BearShang/motor_drv-software/docs/schematic.md

---
title: 原理图
---

# 原理图

## PWR

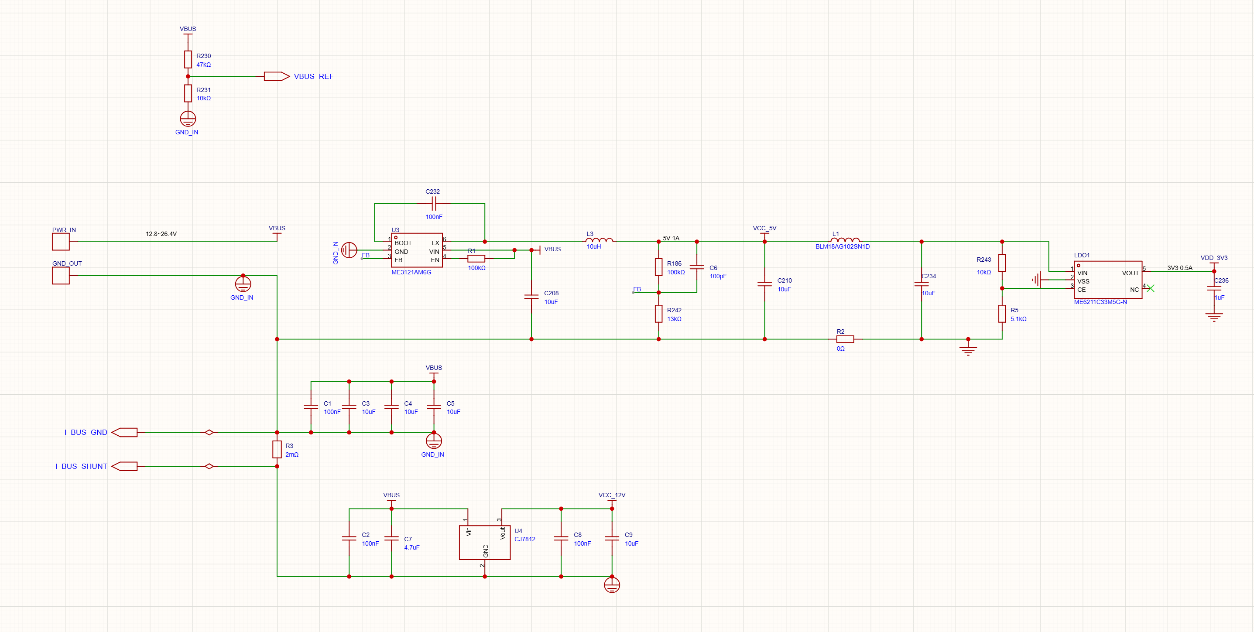
[picture p3: docs/pics/image.png]
PWR 原理图


## MCU

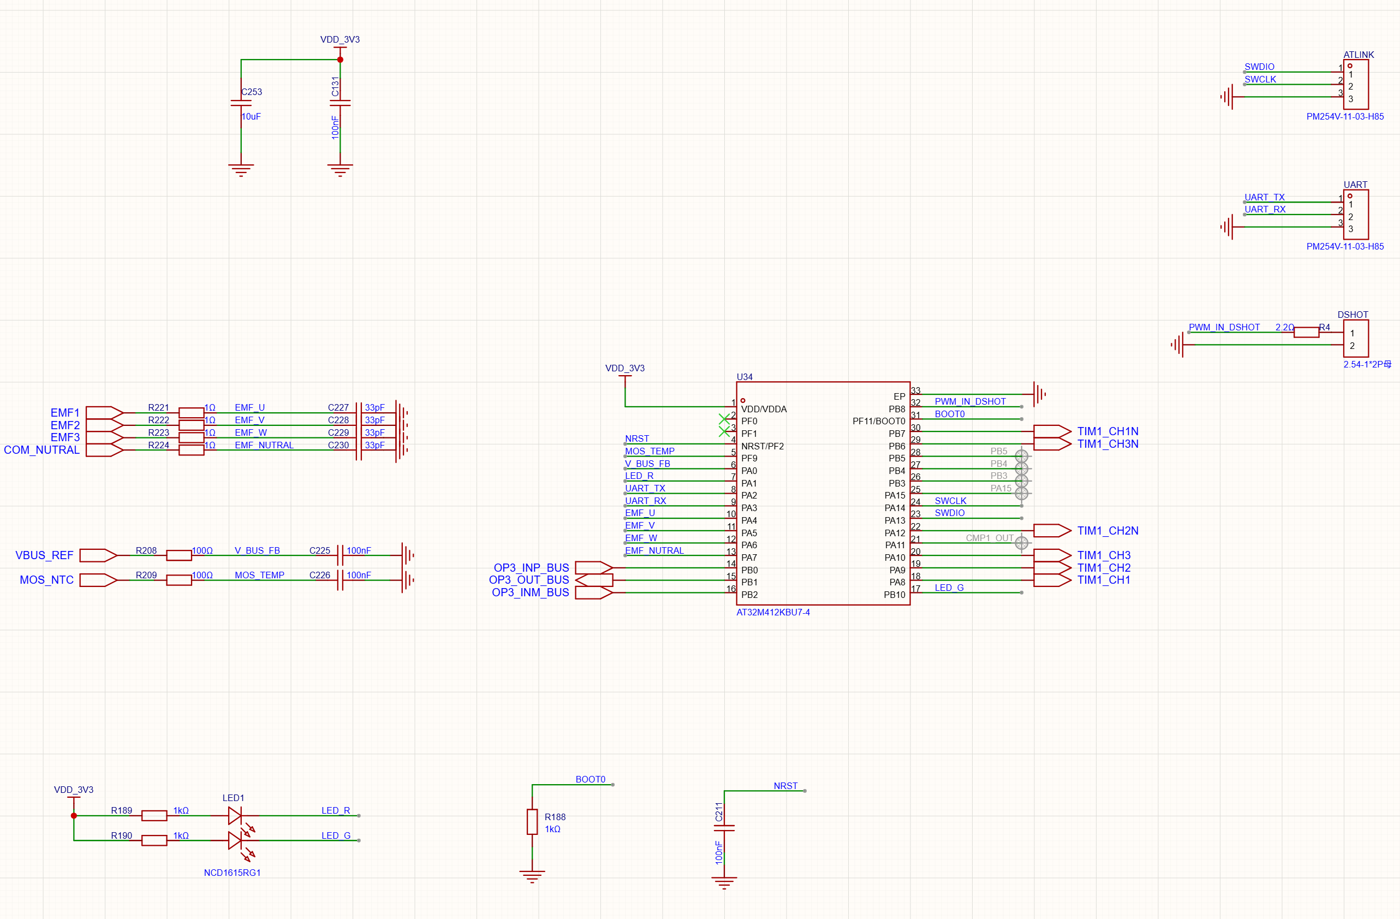
[picture p4: docs/pics/image-1.png]
MCU 原理图


## Driver

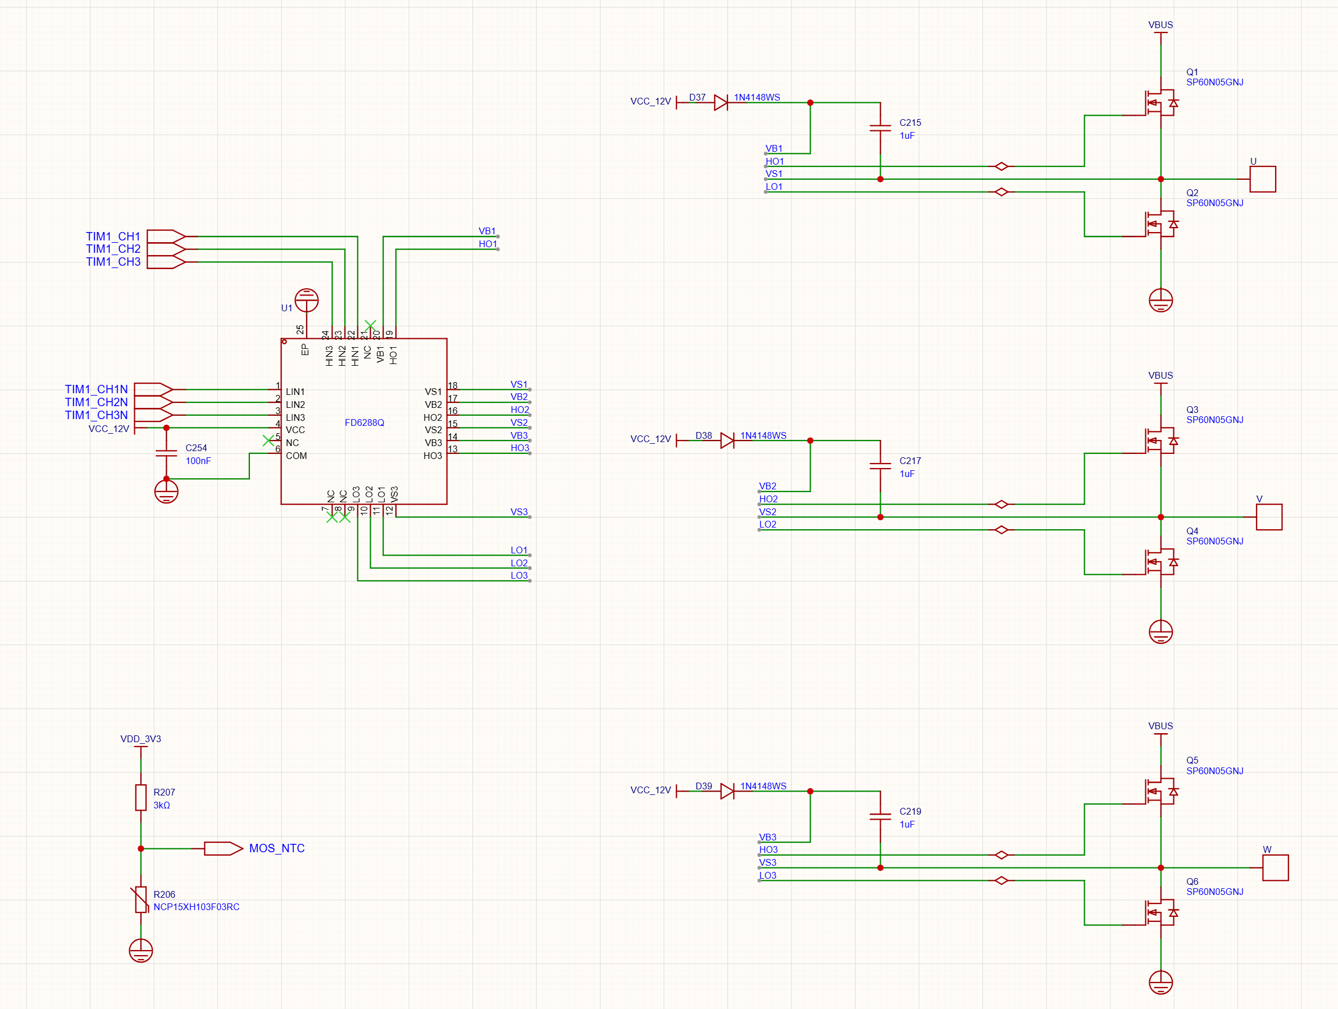
[picture p5: docs/pics/image-2.png]
Driver 原理图


## Sensing

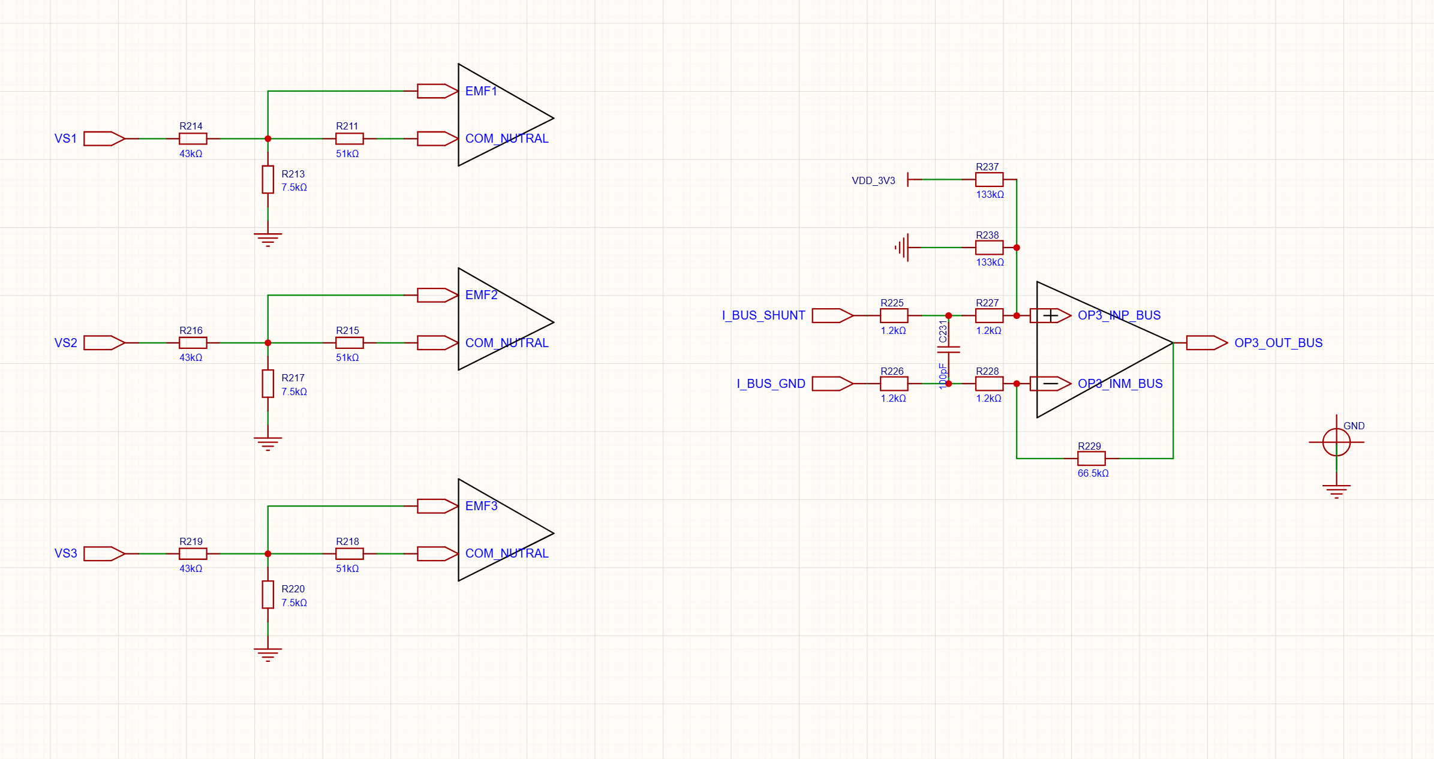
[picture p6: docs/pics/image-3.png]
Sensing 原理图
