BearShang/motor_drv-software/docs/intro.md

---
title: 简介
layout: redirect
redirect_to: /
---
