BearShang/motor_drv-software/docs/pics/motor-control/figure-01.jpg

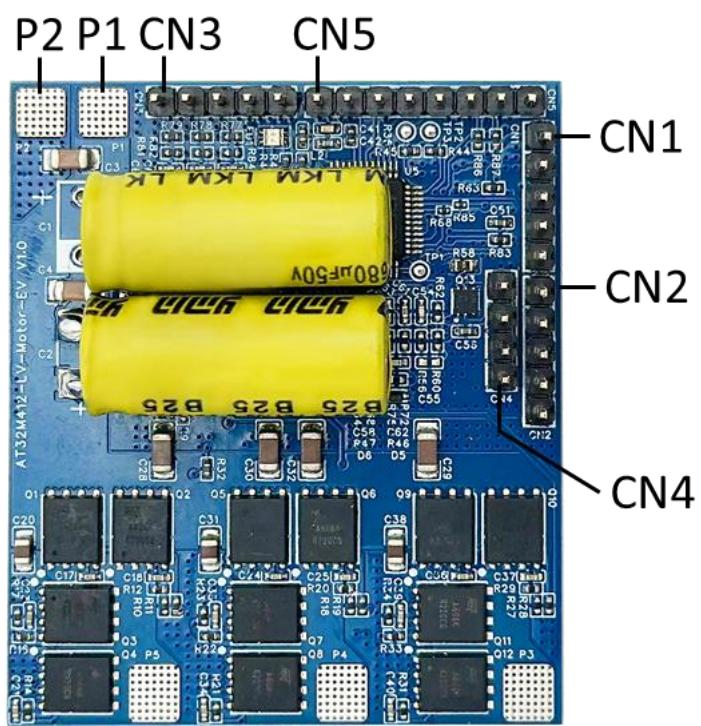
docs/pics/motor-control/figure-01.jpg
