BearShang/motor_drv-software/docs/pics/motor-control/figure-04.jpg

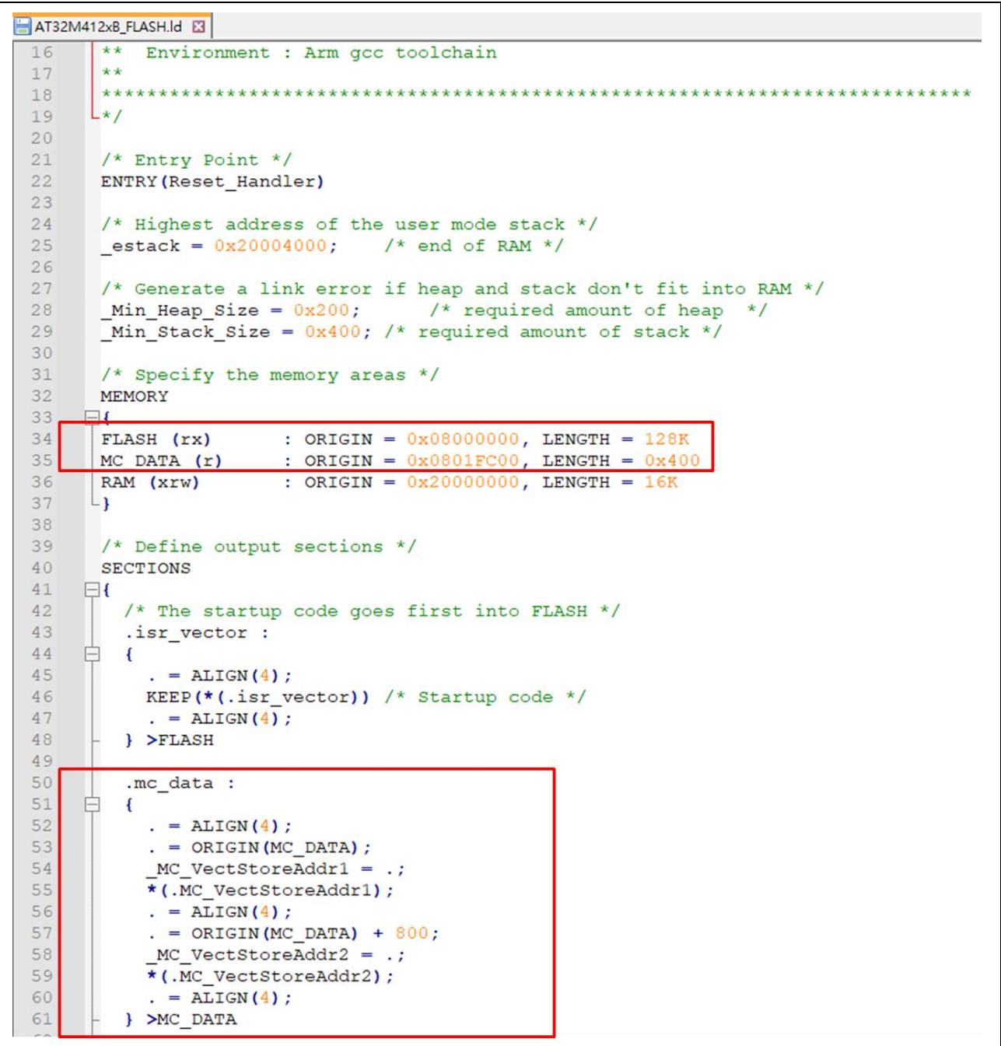
docs/pics/motor-control/figure-04.jpg
