BearShang/motor_drv-software/docs/pics/motor-control/figure-05.jpg

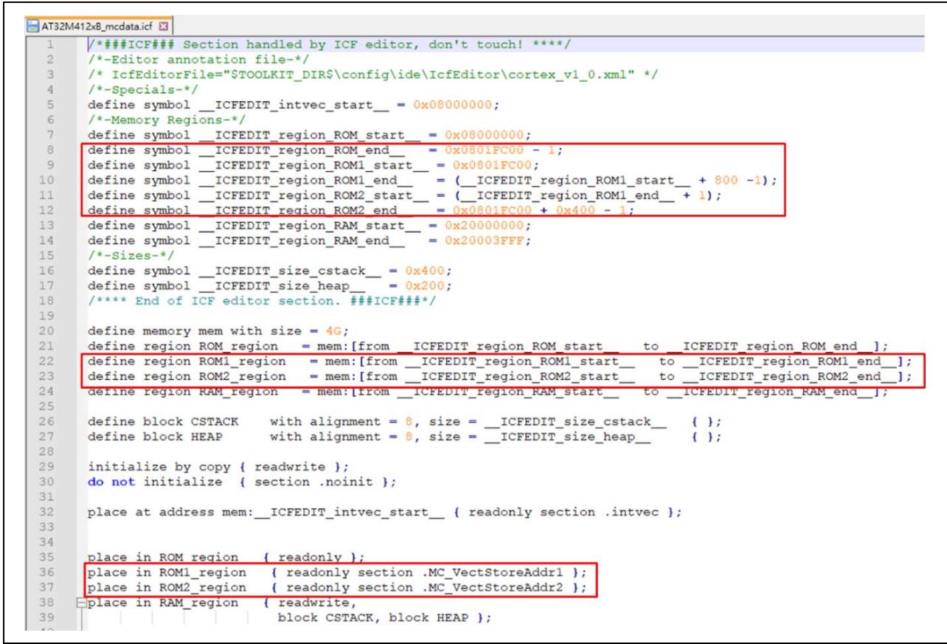
docs/pics/motor-control/figure-05.jpg
