BearShang/motor_drv-software/docs/pics/motor-control/figure-06.jpg

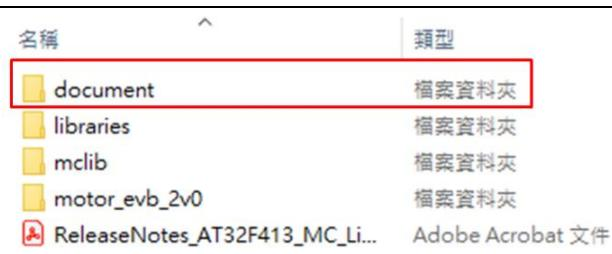
docs/pics/motor-control/figure-06.jpg
