BearShang/motor_drv-software/docs/pics/motor-control/figure-07.jpg

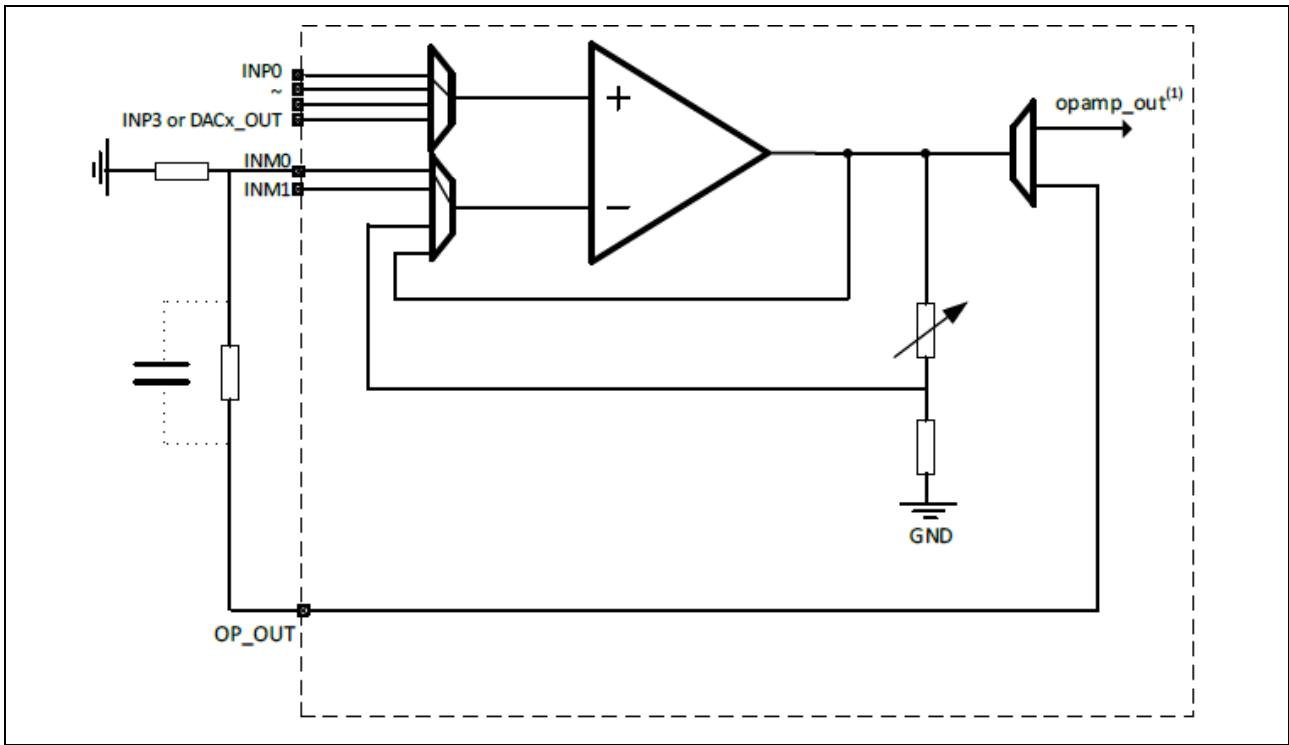
docs/pics/motor-control/figure-07.jpg
