BearShang/motor_drv-software/docs/pics/motor-control/figure-08.jpg

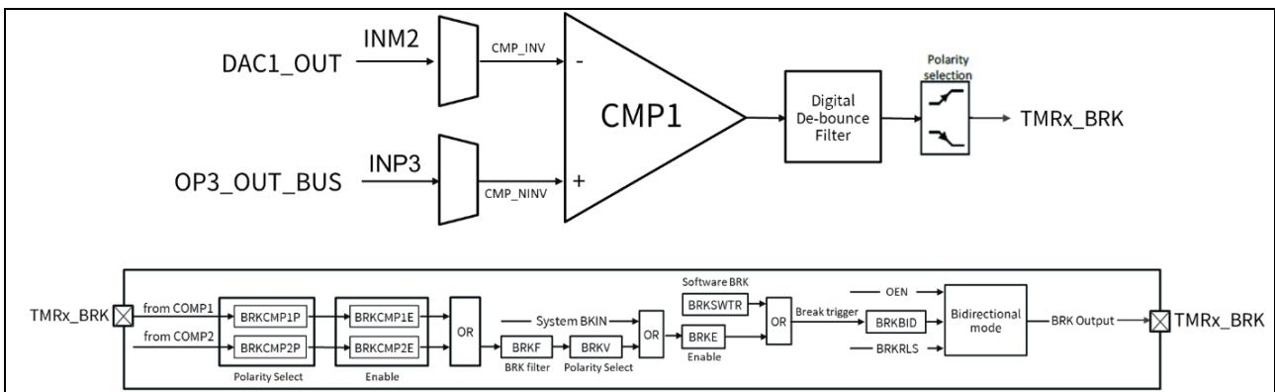
docs/pics/motor-control/figure-08.jpg
