BearShang/motor_drv-software/docs/pics/motor-control/figure-09.jpg

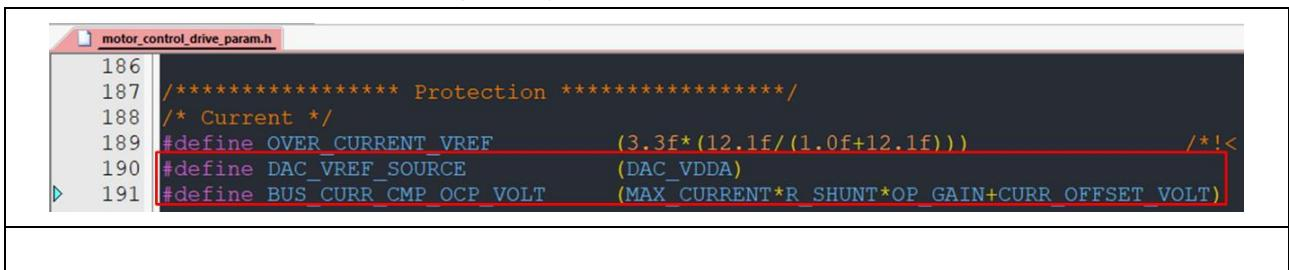
docs/pics/motor-control/figure-09.jpg
