BearShang/motor_drv-software/docs/pics/motor-control/figure-10.jpg

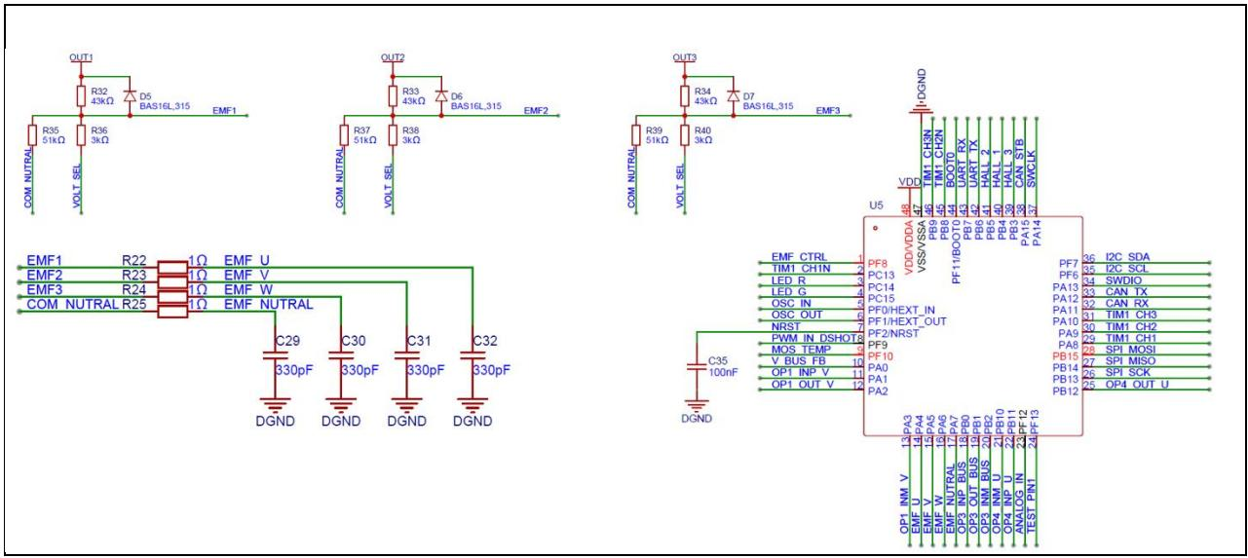
docs/pics/motor-control/figure-10.jpg
