BearShang/motor_drv-software/docs/pics/motor-control/figure-11.jpg

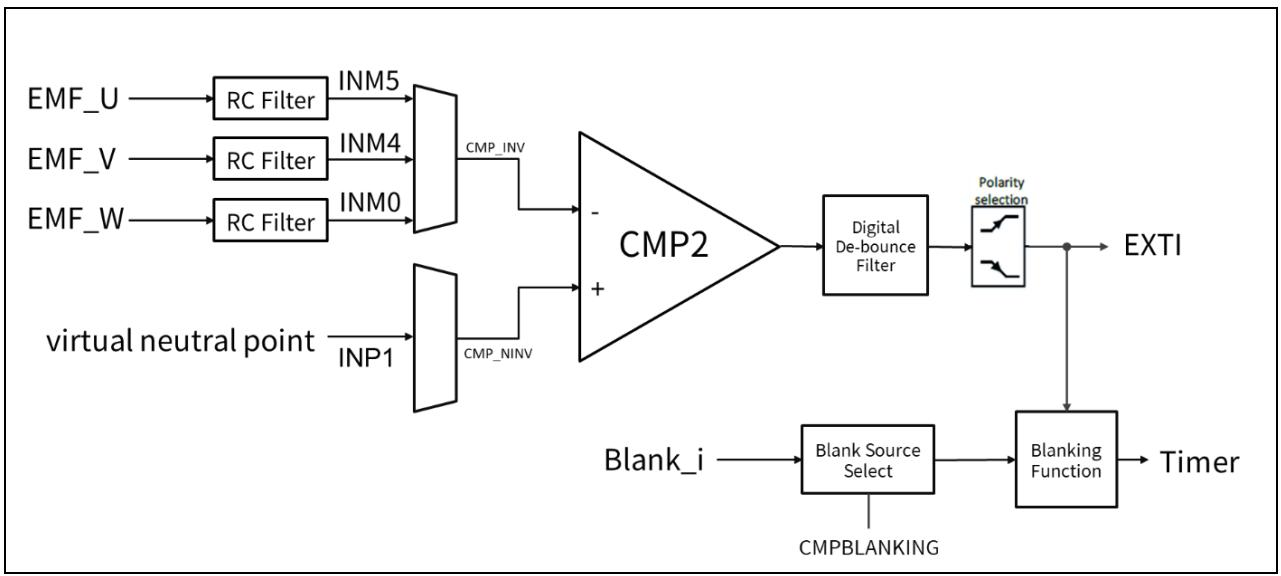
docs/pics/motor-control/figure-11.jpg
