BearShang/motor_drv-software/docs/pics/motor-control/figure-12.jpg

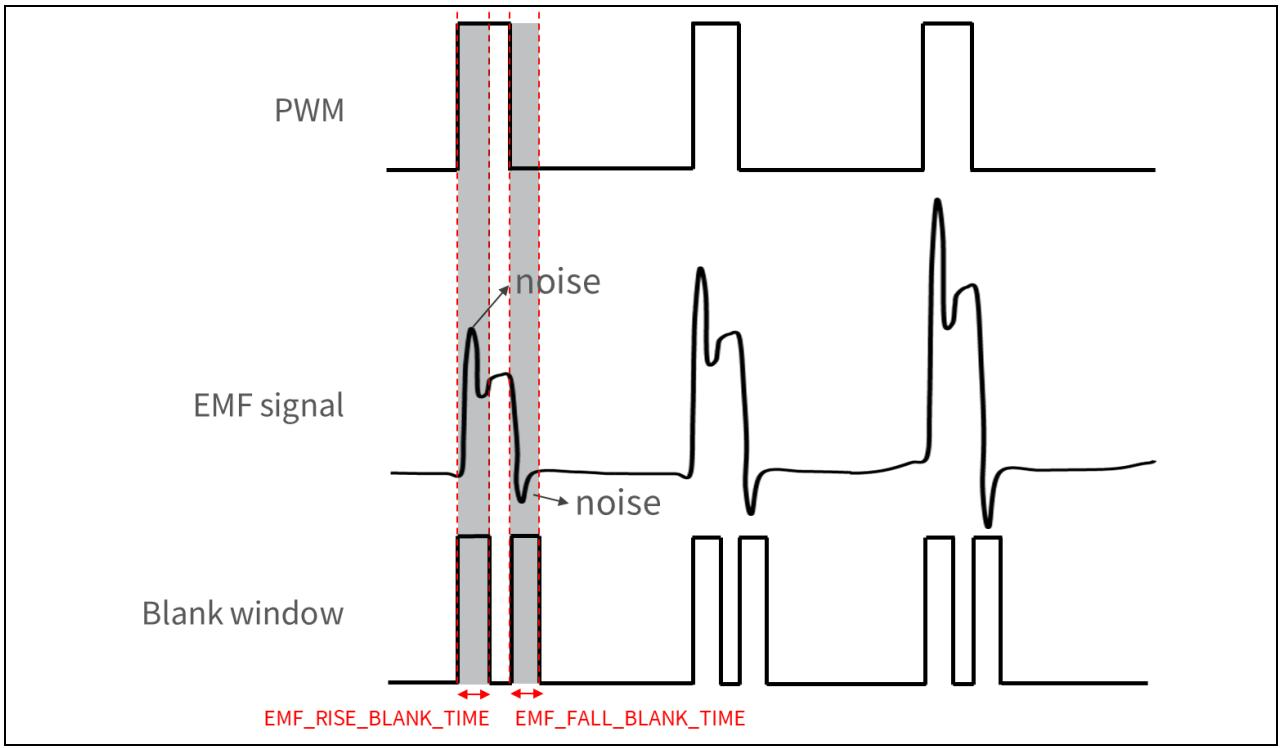
docs/pics/motor-control/figure-12.jpg
