BearShang/motor_drv-software/docs/pics/motor-control/figure-13.jpg

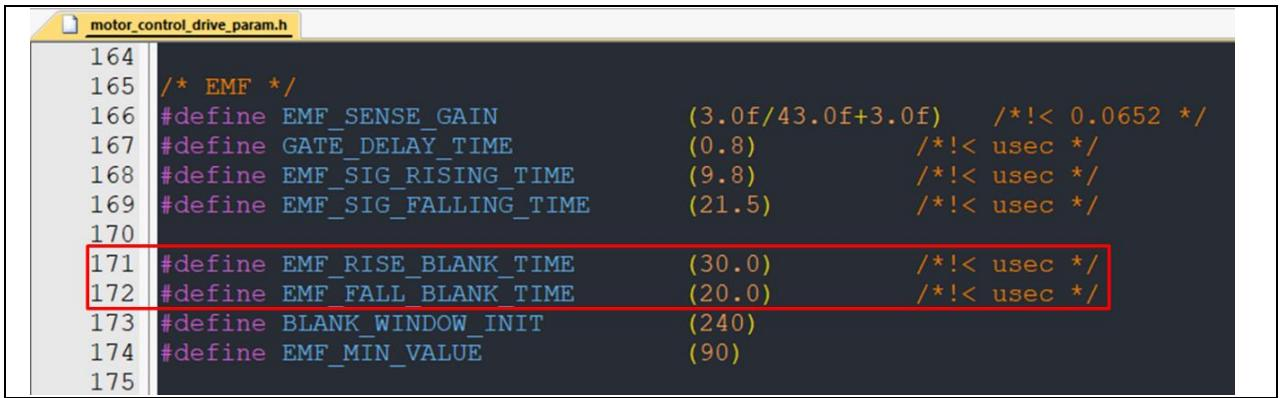
docs/pics/motor-control/figure-13.jpg
