BearShang/motor_drv-software/docs/pics/performance-tuning/basic.png

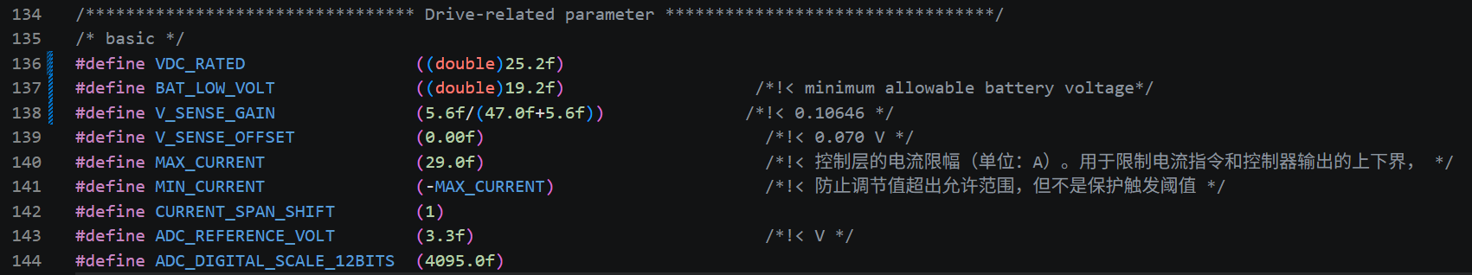
docs/pics/performance-tuning/basic.png
