BearShang/motor_drv-software/docs/pics/performance-tuning/performance-tuning34.jpg

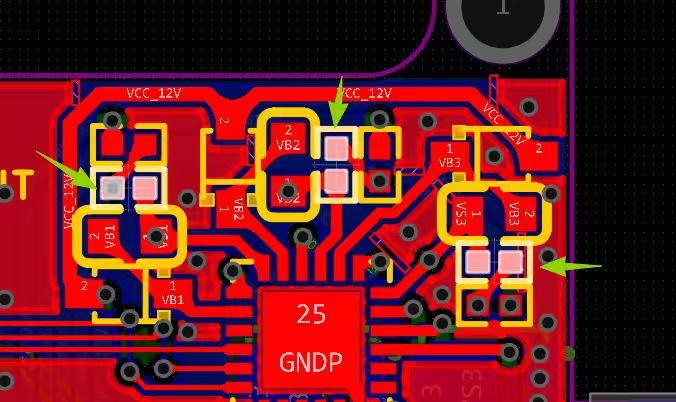
docs/pics/performance-tuning/performance-tuning34.jpg
