BearShang/motor_drv-software/firmware/mclib/src/mc_bldc.c

/**
  **************************************************************************
  * @file     mc_bldc.c
  * @brief    BLDC-related functions
  **************************************************************************
  *                       Copyright notice & Disclaimer
  *
  * The software Board Support Package (BSP) that is made available to
  * download from Artery official website is the copyrighted work of Artery.
  * Artery authorizes customers to use, copy, and distribute the BSP
  * software and its related documentation for the purpose of design and
  * development in conjunction with Artery microcontrollers. Use of the
  * software is governed by this copyright notice and the following disclaimer.
  *
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
  **************************************************************************
  */
#include "mc_lib.h"
extern volatile uint32_t system_time_ms;

/** @addtogroup Motor_Control_Library
  * @{
  */

/** @defgroup mc_bldc
  * @brief BLDC-related functions
  * @{
  */

/**
* @brief  configuration of pwm timer outputs
* @param  hall_states : hall state
* @retval none
*/
void bldc_output_config(uint8_t hall_states)
{
  uint16_t temp;

  temp = PWM_ADVANCE_TIMER->cm1;
  temp &= (~TMR_PWM_MODE_CM1_MASK);
  temp |= tmr_pwm_channel_mode[hall_states][0];
  PWM_ADVANCE_TIMER->cm1 = temp;

  temp = PWM_ADVANCE_TIMER->cm2;
  temp &= (~TMR_PWM_MODE_CM2_MASK);
  temp |= tmr_pwm_channel_mode[hall_states][1];
  PWM_ADVANCE_TIMER->cm2 = temp;

  temp = PWM_ADVANCE_TIMER->cctrl;
  temp &= (~TMR_PWM_OUT_MODE_MASK);
  temp |= tmr_pwm_output_mode[hall_states];
  PWM_ADVANCE_TIMER->cctrl = temp;
}

/**
  * @brief  start bldc setting
  * @param  none
  * @retval none
  */
void start_bldc(void)
{
#if defined HALL_SENSORS
  error_code |= error_code_mask & read_hall_state(&hall);

  /* clear interrupt flags of hall timer */
  tmr_flag_clear(HALL_CAPTURE_TIMER, TMR_OVF_FLAG | TMR_TRIGGER_FLAG | TMR_HALL_FLAG);

  /* set dir: CW or CCW */
  if(ctrl_source == CTRL_SOURCE_EXTERNAL)
  {
#if !defined AT32M412xx
    rotor_speed.dir = gpio_input_data_bit_read(MODE1_BUTTON_PORT, MODE1_BUTTON_PIN);
#endif
  }
  else if(ctrl_source == CTRL_SOURCE_SOFTWARE)
  {
    if(ctrl_mode == SPEED_CTRL)
    {
      if(speed_ramp.cmd_final > 0)
      {
        rotor_speed.dir = CW;
      }
      else
      {
        rotor_speed.dir = CCW;
      }
    }
    else if(ctrl_mode == TORQUE_CTRL)
    {
      if(current.Ibus.Iref > 0)
      {
        rotor_speed.dir = CW;
      }
      else
      {
        rotor_speed.dir = CCW;
      }
    }
  }

  /* set first hall state output */
  bldc_output_config(output_hall_state[rotor_speed.dir][hall.state]);

  if(rotor_speed.dir == CW)
  {
    motor_cw_init();
  }
  else
  {
    motor_ccw_init();
  }

  /* update pwm output mode from shadow buffer of timer cctrl reg. */
  tmr_event_sw_trigger(PWM_ADVANCE_TIMER, TMR_HALL_SWTRIG);

  /* set hall pre_state */
  hall.pre_state = hall.state;

  /* find next hall state */
  hall.next_state = next_hall_state[rotor_speed.dir][hall.state];

  /* set pwm output mode in shadow buffer of timer cctrl reg. */
  bldc_output_config(output_hall_state[rotor_speed.dir][hall.next_state]);

  /* reset counter value */
  PWM_ADVANCE_TIMER->cval = 0;

  /* enable overflow and trigger interrup of hall timer */
  tmr_interrupt_enable(HALL_CAPTURE_TIMER, TMR_C4_INT | TMR_TRIGGER_INT, TRUE);

  /* enable hall timer */
  tmr_counter_enable(HALL_CAPTURE_TIMER, TRUE);

  /* enable pwm timer output */
  tmr_output_enable(PWM_ADVANCE_TIMER, TRUE);

#elif defined SENSORLESS
  /* reset counter value */
  PWM_ADVANCE_TIMER->cval = 0;
  ADC_TIMER->cval = 0;
  blank_trigger.TMRx->cval = 0;
  blank.TMRx->cval = 0;

  /* set pwm output mode in shadow buffer of timer cctrl reg. */
  bldc_output_config(output_hall_state[rotor_speed.dir][hall.state]);

  /* update pwm output mode from shadow buffer of timer cctrl reg. */
  tmr_event_sw_trigger(PWM_ADVANCE_TIMER, TMR_HALL_SWTRIG);

  /* enable pwm timer output */
  tmr_output_enable(PWM_ADVANCE_TIMER, TRUE);

  /* enable blank trigger timer output */
  tmr_output_enable(blank_trigger.TMRx, TRUE);
  tmr_output_enable(blank.TMRx, TRUE);

  /* enable adc timer */
  ADC_TIMER->ctrl1_bit.tmren = TRUE;
  /* enable pwm timer */
  PWM_ADVANCE_TIMER->ctrl1_bit.tmren = TRUE;
  /* enable blank trigger timer */
  blank_trigger.TMRx->ctrl1_bit.tmren = TRUE;
  blank.TMRx->ctrl1_bit.tmren = TRUE;
  COMP_OUT_CAPTURE_TIMER->ctrl1_bit.tmren = TRUE;
#endif
}

/**
  * @brief  Rotor alignment (BLDC)
  * @param  none
  * @retval none
  */
void align_bldc(void)
{
  /* set pwm output mode in shadow buffer of timer cctrl reg. */
  bldc_output_config(hall.state);
  /* update pwm output mode from shadow buffer of timer cctrl reg. */
  tmr_event_sw_trigger(PWM_ADVANCE_TIMER, TMR_HALL_SWTRIG);
  /* set align volt */
  volt_cmd = (int16_t)((uint32_t)(calcValueByVref(LOCK_VOLT_CMD) * vdc_ratio) >> VBUS_GAIN_LOG);
  pwm_comp_value = (volt_cmd * (PWM_PERIOD + 1)) >> 15;

  PWM_ADVANCE_TIMER->c1dt = pwm_comp_value;
  PWM_ADVANCE_TIMER->c2dt = pwm_comp_value;
  PWM_ADVANCE_TIMER->c3dt = pwm_comp_value;

  /* enable pwm timer */
  tmr_counter_enable(PWM_ADVANCE_TIMER, TRUE);

  /* enable pwm timer output */
  tmr_output_enable(PWM_ADVANCE_TIMER, TRUE);
}

/**
  * @brief  Open-loop control function (BLDC)
  * @param  hall_handler : Hall sensor related structure variables
  * @param  openloop_handler : Open-loop related structure variables
  * @param  rotor_speed : Speed-related structure variables
  * @retval none
  */
void bldc_open_loop_ctrl(hall_sensor_type *hall_handler, olc_type *openloop_handler, speed_type *rotor_speed)
{
  volt_cmd = openloop_handler->volt_ref * current.volt_sign;

  if(openloop_handler->olc_count > openloop_handler->period_ref)
  {
    /* Set next state */
    hall_handler->next_state = next_hall_state[rotor_speed->dir][hall_handler->state];

    /* Change mode **/
    bldc_output_config(output_hall_state[rotor_speed->dir][hall_handler->next_state]);

    /* Change phase trigger **/
    tmr_event_sw_trigger(PWM_ADVANCE_TIMER, TMR_HALL_SWTRIG);

    /* Renew hall state */
    hall_handler->state = hall_handler->next_state;

    /* Speed estimation */
    rotor_speed->interval_filter.long_word = openloop_handler->period_ref * PWM_PERIOD * (1 - 2 * rotor_speed->dir);

    /* set flag to calculate motor speed in main function */
    calc_spd_rdy = SET;

    openloop_handler->olc_count = 0;
    rotor_speed->speed_count = 0;
  }
  else
  {
    openloop_handler->olc_count++;
  }
}

/**
  * @brief  bldc hall auto learning function (BLDC)
  * @param  hall_handler : Hall sensor related structure variables
  * @param  hall_learn : Hall Sensor Auto-Learning related structure variables
  * @retval none
  */
void bldc_hall_learning(hall_sensor_type *hall_handler, hall_learn_type *hall_learn)
{
  if(hall_learn->count > hall_learn->learn_period)
  {
    /* Set next state */
    hall_handler->next_state = next_hall_state[hall_learn->dir][hall_handler->next_state];

    /* Change mode **/
    bldc_output_config(output_hall_state[hall_learn->dir][hall_handler->next_state]);

    /* update pwm output mode from shadow buffer of timer cctrl reg. */
    tmr_event_sw_trigger(PWM_ADVANCE_TIMER, TMR_HALL_SWTRIG);

    hall_learn->count = 0;
  }
  else
  {
    hall_learn->count++;
  }
}

/**
  * @brief  Configures PWM braking for motor control
  * @param  brake_force_duty : Braking force duty cycle (0-100%)
  * @note   0% = no braking, 100% = full braking force
  * @retval none
  */
void brake_config(uint16_t brake_force_duty)
{
  uint16_t temp, brake_pwm_cval;
  gpio_init_type gpio_init_struct = {0};

  /* pwm timer output disable */
  tmr_output_enable(PWM_ADVANCE_TIMER, FALSE);
  /* disable pwm timer */
  tmr_counter_enable(PWM_ADVANCE_TIMER, FALSE);

  /* timer pwm output pin Configuration */
  gpio_default_para_init(&gpio_init_struct);
  gpio_init_struct.gpio_mode = GPIO_MODE_OUTPUT;

  /* High-side, Phase A,B,C Config */
  gpio_init_struct.gpio_pins = PWM_PHASE_A_HI_GPIO_PIN;
  gpio_init(PWM_PHASE_A_HI_PORT, &gpio_init_struct);
#if !defined AT32F403Axx && !defined AT32F407xx && !defined AT32F413xx && !defined AT32F415xx
  gpio_pin_mux_config(PWM_PHASE_A_HI_PORT, PWM_PHASE_A_HI_PIN_SOURCE, PWM_PHASE_A_HI_IOMUX);
#endif

  gpio_init_struct.gpio_pins = PWM_PHASE_B_HI_GPIO_PIN;
  gpio_init(PWM_PHASE_B_HI_PORT, &gpio_init_struct);
#if !defined AT32F403Axx && !defined AT32F407xx && !defined AT32F413xx && !defined AT32F415xx
  gpio_pin_mux_config(PWM_PHASE_B_HI_PORT, PWM_PHASE_B_HI_PIN_SOURCE, PWM_PHASE_B_HI_IOMUX);
#endif

  gpio_init_struct.gpio_pins = PWM_PHASE_C_HI_GPIO_PIN;
  gpio_init(PWM_PHASE_C_HI_PORT, &gpio_init_struct);
#if !defined AT32F403Axx && !defined AT32F407xx && !defined AT32F413xx && !defined AT32F415xx
  gpio_pin_mux_config(PWM_PHASE_C_HI_PORT, PWM_PHASE_C_HI_PIN_SOURCE, PWM_PHASE_C_HI_IOMUX);
#endif

  /* close AH/BH/CH */
  gpio_bits_write(PWM_PHASE_A_HI_PORT, PWM_PHASE_A_HI_GPIO_PIN, FALSE);
  gpio_bits_write(PWM_PHASE_B_HI_PORT, PWM_PHASE_B_HI_GPIO_PIN, FALSE);
  gpio_bits_write(PWM_PHASE_C_HI_PORT, PWM_PHASE_C_HI_GPIO_PIN, FALSE);

  temp = PWM_ADVANCE_TIMER->cm1;
  temp &= (~TMR_PWM_MODE_CM1_MASK);
  temp |= BRAKE_PWM_MODE_CM1;
  PWM_ADVANCE_TIMER->cm1 = temp;

  temp = PWM_ADVANCE_TIMER->cm2;
  temp &= (~TMR_PWM_MODE_CM2_MASK);
  temp |= BRAKE_PWM_MODE_CM2;
  PWM_ADVANCE_TIMER->cm2 = temp;

  temp = PWM_ADVANCE_TIMER->cctrl;
  temp &= (~TMR_PWM_OUT_MODE_MASK);
  temp |= BRAKE_PWM_OUT_CCTRL;
  PWM_ADVANCE_TIMER->cctrl = temp;

  /* calculate brake force */
#if defined GATE_DRIVER_LOW_SIDE_INVERT
  brake_pwm_cval = (100 - brake_force_duty) * PWM_PERIOD_DIV_100;
#else
  brake_pwm_cval = brake_force_duty * PWM_PERIOD_DIV_100;
#endif

  /* set brake duty */
  tmr_channel_value_set(PWM_ADVANCE_TIMER, TMR_SELECT_CHANNEL_1, brake_pwm_cval);
  tmr_channel_value_set(PWM_ADVANCE_TIMER, TMR_SELECT_CHANNEL_2, brake_pwm_cval);
  tmr_channel_value_set(PWM_ADVANCE_TIMER, TMR_SELECT_CHANNEL_3, brake_pwm_cval);
  tmr_channel_value_set(PWM_ADVANCE_TIMER, TMR_SELECT_CHANNEL_4, brake_pwm_cval);

  /* update pwm output mode from shadow buffer of timer cctrl reg. */
  tmr_event_sw_trigger(PWM_ADVANCE_TIMER, TMR_HALL_SWTRIG);

  /* reset counter value */
  PWM_ADVANCE_TIMER->cval = 0;

  /* pwm timer output enable */
  tmr_output_enable(PWM_ADVANCE_TIMER, TRUE);

  /* enable pwm timer */
  tmr_counter_enable(PWM_ADVANCE_TIMER, TRUE);
}

/**
  * @brief  Motor beep function - generates audible tone by switching motor coils
  * @param  frequency : Tone frequency in Hz (20~20000 Hz)
  * @param  duration  : Duration in milliseconds
  * @param  volume    : Volume level (0-100), controls PWM duty cycle
  * @retval none
  * @note   Uses two-phase switching to avoid MOS overheating
  */
void motor_beep(uint16_t frequency, uint32_t duration, uint8_t volume)
{
  uint32_t toggle_period_us;
  uint32_t elapsed_us = 0;
  uint32_t total_duration_us = duration * 1000;
  uint16_t pwm_duty;
  uint8_t phase_step = 0;
  
  uint32_t saved_cm1 = PWM_ADVANCE_TIMER->cm1;
  uint32_t saved_cm2 = PWM_ADVANCE_TIMER->cm2;
  uint32_t saved_cctrl = PWM_ADVANCE_TIMER->cctrl;
  uint32_t saved_brk = PWM_ADVANCE_TIMER->brk;
  err_code_type saved_error_code = error_code;

  /* 改动1：OCP 阈值从 10A 放宽到 20A，作为极端情况的最后保险 */
  #define BEEP_FIXED_OCP_DAC_VAL  ((uint16_t)(63.0 * (10.0 * R_SHUNT * OP_GAIN + CURR_OFFSET_VOLT) / ADC_REFERENCE_VOLT))
  dac_1_data_set(BEEP_FIXED_OCP_DAC_VAL);

  /* 改动2：关闭硬件 BRK，这是声音能从"很小"变"响亮"的核心。
     蜂鸣时间很短（几百毫秒）且电机静止，风险可控。 */
  PWM_ADVANCE_TIMER->brk_bit.brken = FALSE;

  tmr_interrupt_enable(PWM_ADVANCE_TIMER, TMR_BRK_INT, FALSE);

  if(frequency < 20) frequency = 20;
  if(frequency > 20000) frequency = 20000;
  if(volume > 100) volume = 100; 

  toggle_period_us = 500000 / frequency;
  if(toggle_period_us < 25) toggle_period_us = 25;

  pwm_duty = (uint16_t)((uint32_t)volume * PWM_PERIOD / 1000); 
  if(pwm_duty < 5) pwm_duty = 5;

  /* 改动3：加占空比硬上限 20%，防止低阻电机在关 BRK 后电流失控。
     如果 20% 声音够了但 MOS 发热，可放宽到 /6(~16%) 或 /8(~12%)。
     如果 20% 还不够且 MOS 不烫，可放宽到 /4(25%)。 */
  #define MAX_BEEP_DUTY  (PWM_PERIOD / 5)
  if(pwm_duty > MAX_BEEP_DUTY)
    pwm_duty = MAX_BEEP_DUTY;

  tmr_output_enable(PWM_ADVANCE_TIMER, FALSE);

  while(elapsed_us < total_duration_us)
  {
    switch(phase_step)
    {
      case 0:
        PWM_ADVANCE_TIMER->cm1 = AH_BL_PWM_MODE_CM1;
        PWM_ADVANCE_TIMER->cm2 = AH_BL_PWM_MODE_CM2;
        PWM_ADVANCE_TIMER->cctrl = AH_BL_PWM_OUT_CCTRL;
        break;
      case 1:
        PWM_ADVANCE_TIMER->cm1 = BH_AL_PWM_MODE_CM1;
        PWM_ADVANCE_TIMER->cm2 = BH_AL_PWM_MODE_CM2;
        PWM_ADVANCE_TIMER->cctrl = BH_AL_PWM_OUT_CCTRL;
        break;
      case 2:
        PWM_ADVANCE_TIMER->cm1 = AH_CL_PWM_MODE_CM1;
        PWM_ADVANCE_TIMER->cm2 = AH_CL_PWM_MODE_CM2;
        PWM_ADVANCE_TIMER->cctrl = AH_CL_PWM_OUT_CCTRL;
        break;
      case 3:
        PWM_ADVANCE_TIMER->cm1 = CH_AL_PWM_MODE_CM1;
        PWM_ADVANCE_TIMER->cm2 = CH_AL_PWM_MODE_CM2;
        PWM_ADVANCE_TIMER->cctrl = CH_AL_PWM_OUT_CCTRL;
        break;
      default:
        phase_step = 0;
        break;
    }

    PWM_ADVANCE_TIMER->c1dt = pwm_duty;
    PWM_ADVANCE_TIMER->c2dt = pwm_duty;
    PWM_ADVANCE_TIMER->c3dt = pwm_duty;

    tmr_event_sw_trigger(PWM_ADVANCE_TIMER, TMR_HALL_SWTRIG);
    tmr_output_enable(PWM_ADVANCE_TIMER, TRUE);

    uint32_t delay_cnt = toggle_period_us;
    while(delay_cnt >= 1000)
    {
      mc_delay_ms(1);
      delay_cnt -= 1000;
    }
    if(delay_cnt > 0)
    {
      mc_delay_us(delay_cnt);
    }
    
    elapsed_us += toggle_period_us;
    phase_step++;
    if(phase_step > 3) phase_step = 0;
  }

  tmr_output_enable(PWM_ADVANCE_TIMER, FALSE);
  PWM_ADVANCE_TIMER->c1dt = 0;
  PWM_ADVANCE_TIMER->c2dt = 0;
  PWM_ADVANCE_TIMER->c3dt = 0;
  
  PWM_ADVANCE_TIMER->cm1 = saved_cm1;
  PWM_ADVANCE_TIMER->cm2 = saved_cm2;
  PWM_ADVANCE_TIMER->cctrl = saved_cctrl;
  tmr_event_sw_trigger(PWM_ADVANCE_TIMER, TMR_HALL_SWTRIG);

  tmr_flag_clear(PWM_ADVANCE_TIMER, TMR_BRK_FLAG);
  if (!(saved_error_code & MC_OVER_CURRENT_ERROR))
  {
    error_code &= ~MC_OVER_CURRENT_ERROR;
  }

  /* 恢复 BRK 和中断，不影响正常运行 */
  PWM_ADVANCE_TIMER->brk = saved_brk;
  tmr_interrupt_enable(PWM_ADVANCE_TIMER, TMR_BRK_INT, TRUE);
  
  dac_1_data_set(DAC_OCP_REF);
}
/**
  * @brief  Play "Castle in the Sky" (Laputa) melody
  * @param  volume : Volume level (0-100)
  * @retval none
  */
void motor_play_laputa(uint8_t volume)
{
  /* Musical Note Frequencies (Hz) */
  #define NOTE_G4  392
  #define NOTE_A4  440
  #define NOTE_B4  494
  #define NOTE_C5  523
  #define NOTE_D5  587
  #define NOTE_E5  659
  #define NOTE_F5  698
  #define NOTE_G5  784

  /* Tempo: Quarter note = 400ms */
  uint32_t q = 400; 
  uint32_t h = q / 2; // Half note (eighth)
  
  /* Melody: 6 7 | 1' 7 1' 3' | 7 - - 3 | 6 5 6 1' | 5 - - */
  
  // 6 7
  motor_beep(NOTE_A4, h, volume); mc_delay_ms(50);
  motor_beep(NOTE_B4, h, volume); mc_delay_ms(50);

  // 1' 7 1' 3'
  motor_beep(NOTE_C5, q + h, volume); mc_delay_ms(50);
  motor_beep(NOTE_B4, h, volume);     mc_delay_ms(50);
  motor_beep(NOTE_C5, q, volume);     mc_delay_ms(50);
  motor_beep(NOTE_E5, q, volume);     mc_delay_ms(50);

  // 7 - - 3
  motor_beep(NOTE_B4, q * 2, volume); mc_delay_ms(50);
  motor_beep(NOTE_E5, h, volume);     mc_delay_ms(50); // Using E5 as high 3

  // 6 5 6 1'
  motor_beep(NOTE_A4, q + h, volume); mc_delay_ms(50);
  motor_beep(NOTE_G4, h, volume);     mc_delay_ms(50);
  motor_beep(NOTE_A4, q, volume);     mc_delay_ms(50);
  motor_beep(NOTE_C5, q, volume);     mc_delay_ms(50);

  // 5 - -
  motor_beep(NOTE_G4, q * 2, volume); mc_delay_ms(50);
}

/**
  * @brief  Play custom startup melody: f4 e4 g3 _ a3 c4 d4
  * @param  volume : Volume level (0-100)
  * @retval none
  */
void motor_play_startup_tone(uint8_t volume)
{
  /* Frequencies for the requested sequence (Hz) */
  #define NOTE_F4  349
  #define NOTE_E4  330
  #define NOTE_G3  196
  #define NOTE_A3  220
  #define NOTE_C4  262
  #define NOTE_D4  294

  uint32_t note_duration = 180; // Standard duration for each note
  uint32_t gap = 40;            // Small gap between notes
  uint32_t long_pause = 150;    // The "_" in the sequence

  // f4 e4 g3
  motor_beep(NOTE_F4, note_duration, volume); mc_delay_ms(gap);
  motor_beep(NOTE_E4, note_duration, volume); mc_delay_ms(gap);
  motor_beep(NOTE_G3, note_duration, volume); 
  
  // _ (Pause)
  mc_delay_ms(long_pause);

  // a3 c4 d4
  motor_beep(NOTE_A3, note_duration, volume); mc_delay_ms(gap);
  motor_beep(NOTE_C4, note_duration, volume); mc_delay_ms(gap);
  motor_beep(NOTE_D4, note_duration, volume); mc_delay_ms(gap);
}
 
