BearShang/motor_drv-software/firmware/at32m412_lv_motor_ev/at32m412/bldc_1shunt_sensorless/src/at32m412_416_clock.c

/**
  **************************************************************************
  * @file     at32m412_416_clock.c
  * @brief    system clock config program
  **************************************************************************
  *                       Copyright notice & Disclaimer
  *
  * The software Board Support Package (BSP) that is made available to
  * download from Artery official website is the copyrighted work of Artery.
  * Artery authorizes customers to use, copy, and distribute the BSP
  * software and its related documentation for the purpose of design and
  * development in conjunction with Artery microcontrollers. Use of the
  * software is governed by this copyright notice and the following disclaimer.
  *
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
  **************************************************************************
  */

/* includes ------------------------------------------------------------------*/
#include "mc_lib.h"
#include "at32m412_416_clock.h"

/** @addtogroup at32m412_lv_motor_ev
  * @{
  */
  
/** @addtogroup bldc_1shunt_sensorless bldc_1shunt_sensorless
  * @{
  */

/** @defgroup at32m412_416_clock
  * @brief system clock config program
  * @{
  */

/**
  * @brief  system clock config program
  * @note   the system clock is configured as follow:
  *         system clock (sclk)   = (hext * pll_ns)/(pll_ms * pll_fr)
  *         system clock source   = pll (hext)
  *         - hext                = 24000000
  *         - sclk                = 180000000
  *         - ahbdiv              = 1
  *         - ahbclk              = 180000000
  *         - apb2div             = 1
  *         - apb2clk             = 180000000
  *         - apb1div             = 1
  *         - apb1clk             = 180000000
  *         - pll_ns              = 60
  *         - pll_ms              = 2
  *         - pll_fr              = 4
  *         - flash_wtcyc         = 5 cycle
  * @param  none
  * @retval none
  */
void system_clock_config(void)
{
  /* reset crm */
  crm_reset();

  /* config flash psr register */
  flash_psr_set(FLASH_WAIT_CYCLE_5);

  /* enable pwc periph clock */
  crm_periph_clock_enable(CRM_PWC_PERIPH_CLOCK, TRUE);

  /* set power ldo output voltage to 1.3v */
  pwc_ldo_output_voltage_set(PWC_LDO_OUTPUT_1V3);

#ifdef INTERNAL_CLOCK_SOURCE
  /* enable hick */
  crm_clock_source_enable(CRM_CLOCK_SOURCE_HICK, TRUE);

  /* wait till hick is ready */
  while(crm_flag_get(CRM_HICK_STABLE_FLAG) != SET)
  {
  }

  /*  if pll clock source selects hext with other frequency values, or configure pll to other
    frequency values, please use the at32 new clock  configuration tool for configuration. */
  crm_pll_config(CRM_PLL_SOURCE_HICK, 90, 1, CRM_PLL_FR_4);

#else
  /* enable hext */
  crm_clock_source_enable(CRM_CLOCK_SOURCE_HEXT, TRUE);

  /* wait till hext is ready */
  while(crm_hext_stable_wait() == ERROR)
  {
  }

  /* if pll parameter has changed, please use the AT32_New_Clock_Configuration tool for new configuration. */
  crm_pll_config(CRM_PLL_SOURCE_HEXT, 60, 2, CRM_PLL_FR_4);
#endif

  /* enable pll */
  crm_clock_source_enable(CRM_CLOCK_SOURCE_PLL, TRUE);

  /* wait till pll is ready */
  while(crm_flag_get(CRM_PLL_STABLE_FLAG) != SET)
  {
  }

  /* config ahbclk */
  crm_ahb_div_set(CRM_AHB_DIV_1);

  /* config apb3clk, the maximum frequency of APB3 clock is 90 MHz */
  crm_apb3_div_set(CRM_APB3_DIV_4);

  /* config apb2clk, the maximum frequency of APB2 clock is 180 MHz */
  crm_apb2_div_set(CRM_APB2_DIV_1);

  /* config apb1clk, the maximum frequency of APB1 clock is 180 MHz */
  crm_apb1_div_set(CRM_APB1_DIV_1);

  /* enable auto step mode */
  crm_auto_step_mode_enable(TRUE);

  /* select pll as system clock source */
  crm_sysclk_switch(CRM_SCLK_PLL);

  /* wait till pll is used as system clock source */
  while(crm_sysclk_switch_status_get() != CRM_SCLK_PLL)
  {
  }

  /* disable auto step mode */
  crm_auto_step_mode_enable(FALSE);

  /* update system_core_clock global variable */
  system_core_clock_update();
}
