BearShang/motor_drv-software/firmware/at32m412_lv_motor_ev/at32m412/bldc_1shunt_sensorless/src/at32m412_416_int.c

/**
  **************************************************************************
  * @file     at32m412_416_int.c
  * @brief    main interrupt service routines.
  **************************************************************************
  *                       Copyright notice & Disclaimer
  *
  * The software Board Support Package (BSP) that is made available to
  * download from Artery official website is the copyrighted work of Artery.
  * Artery authorizes customers to use, copy, and distribute the BSP
  * software and its related documentation for the purpose of design and
  * development in conjunction with Artery microcontrollers. Use of the
  * software is governed by this copyright notice and the following disclaimer.
  *
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
  **************************************************************************
  */

/* includes ------------------------------------------------------------------*/
#include "at32m412_416_int.h"

/** @addtogroup at32m412_lv_motor_ev
  * @{
  */
  
/** @addtogroup bldc_1shunt_sensorless bldc_1shunt_sensorless
  * @{
  */

/** @defgroup at32m412_416_int
  * @brief main interrupt service routines.
  * @{
  */

extern __IO uint16_t adc1_preempt_valuetab[2][3];
extern __IO uint16_t adc2_preempt_valuetab[2][3];
extern __IO uint16_t adc1_preempt_conversion_count;
extern __IO uint16_t adc2_preempt_conversion_count;
extern __IO uint32_t adc1_overflow_flag;
extern __IO uint32_t adc2_overflow_flag;
extern __IO uint32_t adc1_conversion_fail_flag;
extern __IO uint32_t adc2_conversion_fail_flag;

extern void adc_convert_recovery_process(void);

/**
  * @brief  this function handles nmi exception.
  * @param  none
  * @retval none
  */
void NMI_Handler(void)
{
}

/**
  * @brief  this function handles hard fault exception.
  * @param  none
  * @retval none
  */
void HardFault_Handler(void)
{
  /* go to infinite loop when hard fault exception occurs */
  while(1)
  {
  }
}

/**
  * @brief  this function handles memory manage exception.
  * @param  none
  * @retval none
  */
void MemManage_Handler(void)
{
  /* go to infinite loop when memory manage exception occurs */
  while(1)
  {
  }
}

/**
  * @brief  this function handles bus fault exception.
  * @param  none
  * @retval none
  */
void BusFault_Handler(void)
{
  /* go to infinite loop when bus fault exception occurs */
  while(1)
  {
  }
}

/**
  * @brief  this function handles usage fault exception.
  * @param  none
  * @retval none
  */
void UsageFault_Handler(void)
{
  /* go to infinite loop when usage fault exception occurs */
  while(1)
  {
  }
}

/**
  * @brief  this function handles svcall exception.
  * @param  none
  * @retval none
  */
void SVC_Handler(void)
{
}

/**
  * @brief  this function handles debug monitor exception.
  * @param  none
  * @retval none
  */
void DebugMon_Handler(void)
{
}

/**
  * @brief  this function handles pendsv_handler exception.
  * @param  none
  * @retval none
  */
void PendSV_Handler(void)
{

}


/**
  * @}
  */

/**
  * @}
  */
