BearShang/motor_drv-software/(commit log)

2025-10-27 首次编译后同步一下
2025-10-28 fix(mdk_v5): 更新目标设备为AT32M412KBU7-4并调整调试配置
    修改项目配置以适配AT32M412KBU7-4芯片，更新调试器设置和编译输出文件
2025-10-28 fix(hwio): 更新PWM相位引脚配置和UART1 TX引脚位置
    修改PWM相位A/B/C的低侧引脚配置，将相位A/B的低侧引脚从GPIOC/GPIOB改为GPIOA，并调整引脚号。同时将UART1 TX引脚从GPIOB6改为GPIOA15。这些更改适配了新的硬件设计需求。
    build: 更新项目配置使用AT32M412KBU7_4芯片定义
    [mc_hwio_m412_lv_v1_0.h]
2025-10-28 日常更新
2025-10-29 删掉了其余方案的源码
2025-10-29 refactor(hwio): 移除未使用的GPIO初始化函数并更新LED引脚配置
    - 注释掉未使用的gpio_output_init函数
    - 更新LED引脚配置，将LED_R和LED_G从GPIOC移至GPIOA
    - 移除未使用的测试引脚定义
2025-10-31 chore: 删除不再使用的IDE项目文件和配置
    refactor: 更新MDK项目编译输出文件和映射文件
    更新了MDK项目的编译输出文件(.o, .axf)和映射文件(.map)，反映了最新的代码变更和编译结果。同时删除了不再使用的IAR和AT32 IDE项目文件，包括配置文件(.prefs, .ini)和链接脚本(.ld, .icf)，以保持项目整洁。
2025-11-03 refactor(mclib): 移除FOC相关库文件和代码
    清理不再使用的FOC控制相关源文件和头文件，包括：
    1. 删除多个FOC内核库文件(.a/.lib)
    2. 移除FOC控制核心实现文件(mc_foc.c/h)
    3. 删除FOC无传感器控制文件(mc_foc_sensorless.h)
    4. 移除FOC电机控制状态机实现文件
    5. 删除磁编码器驱动文件(TLE5012B/AS5047P)
    6. 清理MTPA/MTPV查表文件
    7. 更新构建日志和调用图文件
    同时调整VSCode配置，添加type_traits文件关联
2025-11-03 refactor: 移除未使用的FOC闪存数据表文件并更新构建日志
    移除mclib/src/mc_flash_data_table_foc.c文件，该文件包含未使用的FOC闪存数据表实现。
    同时更新构建日志文件中的编译顺序和构建时间。
2025-11-03 fix: 更新VS Code设置和Keil项目文件
    更新.vscode/settings.json文件，添加cmath和cstdlib的文件关联
    修改Keil项目文件中的窗口位置设置和编译顺序
    更新motor_control_drive_param.h文件的依赖信息
2025-11-05 fix(bldc): 修正电机速度计算并添加代码注释
    添加对"compare"文件的C语言关联配置
    在电机速度计算中添加注释说明计算原理
    为闭环控制触发条件添加注释说明
    [main.c, mc_isr.c]
2025-11-06 fix(motor_control): 更新电机驱动参数以匹配新电机规格
    修改了定子电阻、极对数、反电动势常数等参数，同时调整了额定电压、最低电池电压和最大电流限制，以适应新更换的电机型号
2025-11-07 fix: 更新电机参数中的定子电阻和电感值
    将定子电阻从0.51欧姆调整为0.31欧姆，定子电感从0.002387H调整为0.0092H，以匹配实际电机特性
2025-11-13 feat(main): 添加LED闪烁功能并交换红绿LED引脚定义
    refactor(hwio): 交换LED_R和LED_G的GPIO引脚定义
    style(uvoptx): 更新调试配置和监视窗口变量
    chore: 更新构建日志和依赖文件
2025-11-13 fix(hwio): 禁用错误LED初始化并修改UART RX复用配置
    refactor(motor_control): 移除错误状态LED控制逻辑
    [mc_hwio.c, mc_hwio_m412_lv_v1_0.h, motor_control_bldc.c]
2025-11-13 fix(hwio): 更新UART引脚复用配置为GPIO_MUX_7
    修改了mc_hwio_m412_lv_v1_0.h文件中UART TX/RX引脚的复用配置，从GPIO_MUX_6改为GPIO_MUX_7，以匹配硬件设计需求
    [mc_hwio_m412_lv_v1_0.h]
2025-11-13 fix(motor_control): 更新电压检测参数和PWM引脚配置
    - 修改电压检测分压比和ADC参考电压
    - 调整PWM相位引脚复用配置
    - 更新过压和欠压保护阈值
    - 修正电压基准计算值注释
    [mc_bldc_globals.h, mc_hwio_m412_lv_v1_0.h, motor_control_drive_param.h]
2025-11-14 fix(motor_control): 降低最大电流和过流保护阈值
    将MAX_CURRENT从38.0A降低至20.0A，OVER_CURRENT_SW从48.0A降低至30.0A
    启用GATE_DRIVER_LOW_SIDE_INVERT配置
    [motor_control_drive_param.h]
2025-11-14 fix(motor_control): 调整PWM频率和死区时间参数
    将PWM频率从15kHz提高到20kHz，并将死区时间从300ns设置为0ns，硬件驱动电路自带了250ns
2025-11-15 fix(motor_control): 禁用电压和温度保护并设置死区时间
    - 在mc_isr.c中注释掉电压和温度保护检查代码
    - 将motor_control_drive_param.h中的死区时间从0ns改为200ns
    - 代码优化减少了栈使用和程序大小
    [mc_isr.c, motor_control_drive_param.h]
2025-11-17 fix(motor_control): 调整启动参数并优化代码
    - 修改最小转速从200RPM降至100RPM
    - 调整开环启动电压从0.75V降至0.13V
    - 优化电压增量从0.006调整为0.004
    - 注释掉低边驱动反相逻辑定义
    - 小幅优化函数代码大小
    [motor_control_drive_param.h]
2025-11-17 fix(motor_control): 调整PID参数和窗口位置默认值
    更新电流环PID控制器的默认参数值，将KP从300增加到31000，KI从4500减少到2600，KP_DIV从32768减少到8192。同时修改了窗口最小位置的默认值从(-1,-1)到(-32000,-32000)，并更新了相关编译输出文件。
2025-11-18 fix(motor_control): 重新启用电压保护检测并调整PID参数
    - 在mc_isr.c中取消注释电压保护检测代码
    - 修改motor_control_drive_param.h中的PID参数和启动参数
    - 调整OLC_TIMES从120增加到200
    - 修改OLC_STARTUP_PERIOD从500ms增加到1500ms
    - 更新PID_SPD_KP_DIV和PID_SPD_KI_DIV值
    [mc_isr.c, motor_control_drive_param.h]
2025-11-18 fix(pid): 调整低速电压控制PID的KP默认值从3000到5000
    优化低速时的电压控制响应，提高系统稳定性
2025-11-24 fix(motor_control): 调整低速和高速滞环阈值并启用电流环控制
    将低速滞环阈值从800rpm调整为600rpm，高速滞环阈值从1000rpm调整为800rpm
    移除WITHOUT_CURRENT_CTRL宏定义以启用电流环控制功能
    [motor_control_drive_param.h]
2025-11-24 fix(hwio): 修改PWM输入通道和MOS温度ADC通道配置
    更新PWM输入通道从CH1改为CH3，并调整相关GPIO配置
    将MOS温度ADC通道从CH24改为CH23，并更新对应GPIO引脚
    优化adc_ordinary_config函数的栈使用
    [mc_hwio_m412_lv_v1_0.h]
2025-11-24 fix(motor_control): 修正电流检测增益和偏移电压参数
    refactor(bldc_globals): 优化DAC_OCP_REF计算逻辑，增加范围限制
    更新电流检测电路参数，将增益调整为27.708，偏移电压设为1.65V。同时改进DAC_OCP_REF宏定义，增加0-63的范围限制和四舍五入处理。这些修改提高了电流检测精度和系统稳定性。
    [mc_bldc_globals.h, motor_control_drive_param.h]
2025-12-02 fix(mclib): 修正DAC_OCP_REF计算精度问题
    将DAC_OCP_REF从uint8_t改为uint16_t类型，避免计算过程中的精度损失
2025-12-02 fix(motor_control): 启用MOS温度保护并调整电机参数配置
    - 取消mc_isr.c中MOS温度保护代码的注释
    - 在motor_control_drive_param.h中：
    * 启用SPECIFIC_EACH_EMF_PIN配置
    * 禁用MOTOR_PARAM_IDENTIFY功能
    - 优化编译顺序，减少代码体积
    [mc_isr.c, motor_control_drive_param.h]
2025-12-02 docs(motor_control): 更新电机控制参数注释和配置说明
    完善电机控制驱动参数文件的注释，添加中文说明以增强可读性。主要修改包括：
    - 添加相位提前功能的详细使用说明
    - 补充初始角度检测参数的单位说明
    - 明确电流限幅参数的作用
    - 修正启动对齐参数描述
    - 添加速度环切换点功能说明
    [motor_control_drive_param.h]
2025-12-03 chore: 更新VSCode设置和电机控制参数配置
    - 在VSCode设置中添加mc_lib.h头文件映射
    - 调整电机控制驱动参数中的EMF采样相关注释和配置
    - 修复MDK工程文件中的构建按钮配置
    [mc_isr.c, motor_control_drive_param.h]
2025-12-03 fix(motor_control): 更新温度传感器参数并优化编译顺序
    调整温度传感器的基准电压V0_V从2.81943V改为2.5385V，基准温度T0_C从0°C改为25°C，温度系数dV_dT从-0.0242314改为-0.0228。同时优化了MDK项目的编译文件顺序，减少构建时间从11秒降至3秒。
2025-12-04 fix(motor_control): 修正电压基准计算并添加电压感应偏移
    在电压基准计算中增加电压感应偏移量V_SENSE_OFFSET，以更准确地反映实际电压值
2025-12-05 fix(motor_control): 修正电压基准计算和电流采样参数
    调整电压基准计算公式中的偏移量符号，从减号改为加号
    更新电流采样最小时间和延迟参数，优化采样性能
    修改ADC参考电压和电流偏移电压值，提高测量精度
    [mc_bldc_globals.h, motor_control_drive_param.h]
2025-12-05 fix(motor_control): 调整电流采样参数和PID默认值
    优化电流采样时间参数，将最小采样时间从60ns增加到400ns，延迟从600ns增加到700ns
    调整PID默认参数，KP从31000改为8192，KI从2600改为1
    修正电流偏移电压计算方式，使用ADC参考电压的一半
    [motor_control_drive_param.h]
2025-12-09 feat: 更新电机控制参数和配置
    - 调整电流采样参数和死区时间
    - 更新VSCode配置文件和扩展推荐
    - 修改最大电流限制和电压检测参数
    - 优化无感BLDC控制算法初始化注释
    - 调整电流反馈滤波和转换逻辑
2025-12-12 fix(motor_control): 更新电机参数和PID设置以优化性能
    调整了反电动势常数(KE)、ADC参考电压、电流采样时间等参数
    修改了PID控制器的默认参数和分频系数
    提高了最大转速限制从7200rpm到11900rpm
    优化了EMF检测的空白时间设置
    [motor_control_drive_param.h]
2025-12-12 fix(motor_control): 更新电机参数和电流采样配置
    - 启用电流低通滤波模式
    - 调整定子电阻值从0.31Ω改为0.51Ω
    - 优化电流采样最小时间和延迟参数
    - 重新编译生成新的目标文件
    [motor_control_drive_param.h]
2025-12-15 fix(硬件IO配置): 更新LED引脚配置
    将红色LED引脚从PA3改为PA1，绿色LED引脚从PA2改为PB10
2025-12-15 fix(hwio): 修改PWM相位A低端驱动引脚配置及UART通信配置
    将PWM相位A低端驱动引脚从GPIOA11改为GPIOB7，并更新相关时钟配置
    将UART通信从USART1改为USART2，调整对应引脚和DMA配置
    修复LED初始化函数中的端口配置问题
    [mc_hwio_m412_lv_v1_0.h]
2025-12-15 fix: 更新mc_hwio_m412_lv_v1_0.h文件哈希值并调整编译顺序
    调整了多个源文件的编译顺序，并更新了mc_hwio_m412_lv_v1_0.h文件的哈希值引用
2025-12-18 fix(motor_control): 调整电机控制参数并修复电流读取逻辑
    - 修改PID控制器参数(PID_IS_KP_DEFUALT和PID_IS_KI_DEFUALT)
    - 调整电流调谐参数(TUNE_TARGET_CURRENT和TUNE_CURRENT_STEP_PERIOD)
    - 修复电机参数识别模式下的电流读取逻辑
    - 取消电流低通滤波(CURRENT_LP_FILTER)
    - 启用GPIO输出初始化函数
    - 更新UART DMA相关注释
    [mc_hwio.c, mc_hwio_m412_lv_v1_0.h, mc_isr.c, motor_control_drive_param.h]
2025-12-18 feat(main): 添加测试用的gpio_output_init初始化调用
    refactor(mc_hwio): 移除未使用的测试GPIO初始化代码
2026-01-05 fix(hwio): 交换LED_R和LED_G的GPIO引脚配置
    feat(control): 启用电流低通滤波并调整PID参数
    - 启用CURRENT_LP_FILTER宏
    - 调整PID_IS_KP_DEFAULT和PID_IS_KI_DEFAULT值
    - 修改I_SAMP_DELAY为400nsec
    refactor(build): 调整编译文件顺序和优化程序大小
    [mc_hwio_m412_lv_v1_0.h, motor_control_drive_param.h]
2026-01-05 fix(motor_control): 更新电机控制驱动参数配置
    修改motor_control_drive_param.h文件中的参数配置，优化电机控制性能
2026-01-05 fix(电机控制): 将死区时间从100ns减少到50ns以优化开关损耗
    根据MOSFET/IGBT/IPM规格调整死区时间参数，减少开关损耗同时确保系统稳定性
2026-01-06 fix(motor_control): 调整PID积分参数从400到500以优化控制性能
2026-01-07 fix(motor_control): 优化BLDC无感控制参数和硬件配置
    - 调整EMF空白时间和滤波参数以提高低速稳定性
    - 修改死区时间从50ns增加到100ns
    - 更新PID控制参数和速度切换点
    - 优化比较器输出捕获滤波器配置
    - 移除测试用的GPIO初始化代码
    - 更新调试窗口监视变量
    [main.c, mc_bldc_sensorless.c, mc_hwio.c, mc_hwio_m412_lv_v1_0.h, motor_control_drive_param.h]
2026-01-08 fix(hwio): 调整比较器滤波参数以提高信号稳定性
    - 修改BEMF比较器滤波参数从0x1f到0x3f
    - 更新定时器比较输出捕获滤波器值从0x03到0x0F
    - 优化电机控制参数以提升性能
    [mc_hwio.c, mc_hwio_m412_lv_v1_0.h]
2026-01-09 fix: 调整BEMF比较器滤波参数和空白时间设置
    修改BEMF比较器的滤波参数从0x3f降低到0x10以优化噪声抑制
    调整高低速下的EMF下降沿空白时间设置，提高电机控制稳定性
    更新定时器捕获滤波参数从0xF改为0x3
    [mc_hwio.c, mc_hwio_m412_lv_v1_0.h, motor_control_drive_param.h]
2026-01-09 fix(motor_control): 优化BEMF比较器滤波参数和相位切换逻辑
    调整BEMF比较器的数字滤波器参数从0x10改为0x3f以提高稳定性
    缩短高速时的EMF下降消隐时间从10us到3us
    在相位切换函数中添加GPIOA15翻转用于调试
    更新定时器比较输出捕获滤波器值为0xa
    [mc_bldc_sensorless.c, mc_hwio.c, mc_hwio_m412_lv_v1_0.h, motor_control_drive_param.h]
2026-01-09 fix: 调整默认速度环PID比例系数从5000至3000
    优化电机控制参数，降低默认比例系数以提高系统稳定性
2026-01-09 添加测试点和速度pi参数
2026-01-09 修改到40khz 稳定在7000转
2026-01-10 feat(hwio): 添加相位变化触发引脚配置并优化PWM频率和PID参数
    refactor(main): 移除冗余的GPIO初始化函数并启用标准GPIO输出初始化
    chore(keil): 更新Keil项目配置至ARMCLANG V6.19
    perf(control): 提高PWM频率至24kHz并优化速度环PID参数
    fix(deadtime): 调整死区时间至50ns以匹配硬件特性
    [main.c, mc_hwio.c, mc_hwio_m412_lv_v1_0.h, motor_control_drive_param.h]
2026-01-10 fix(电机控制): 调整PID参数并禁用相位提前功能
    - 将PID_IS_KP_DEFUALT从3000调整为2500，PID_IS_KI_DEFUALT从150调整为245以优化控制性能
    - 注释掉PHASE_ADVANCE宏定义，默认不启用相位提前功能
    [motor_control_drive_param.h]
2026-01-14 refactor(motor_control): 移除EMF连续采样和特定引脚配置
    调整低速PID控制参数，优化电压控制性能
2026-01-15 fix(motor_control): 调整传感器参数并移除测试代码
    - 启用相位提前功能
    - 调整EMF空白时间和转速阈值
    - 移除bldc_sensorless_change_phase中的测试代码
    - 更新构建日志和依赖文件
    [mc_bldc_sensorless.c, motor_control_drive_param.h]
2026-01-16 fix(hwio): 修改比较器输出引脚配置从GPIOA12到GPIOB5 fix(drive_param): 调整EMF空白时间和PWM频率参数 refactor(hwio): 清理未使用的代码并添加GPIOA15初始化
    [mc_hwio.c, mc_hwio_m412_lv_v1_0.h, motor_control_drive_param.h]
2026-01-16 fix(motor_control): 降低过流保护阈值以提高安全性
    将OVER_CURRENT_SW从30A降至20A，OCP_CURRENT从50A降至30A，以增强电机控制系统的安全保护
2026-01-19 优化消隐参数
2026-01-22 fix(motor_control): update overcurrent protection threshold from 30A to 21A
    [motor_control_drive_param.h]
2026-01-27 最新的消隐和内部晶振，对齐启动
2026-01-27 低速和高速消隐有所改动
2026-02-06 对应24v的电压更改参数
2026-03-03 现在4s电池kv900电机11寸桨叶调好的配套代码
2026-03-04 kv900-10寸桨叶-调好的消隐和pid参数
2026-03-16 Update nTsel value in bldc_1shunt_sensorless configuration to 6
2026-03-16 差个CRC校检
2026-03-16 好像校检也通过了
2026-03-17 改了下硬件滤波
2026-03-17 加debug变量
2026-03-17 完美不抖
2026-03-18 发送传输错误后油门保持，不清零； 添加了注释
2026-03-18 最终版本已经通过飞控控制电机了
2026-03-18 注释掉调试变量
2026-04-20 最新的消隐和pid加速度
2026-04-21 添加了ignore，忽略中间产物
2026-04-21 移除已跟踪的编译中间产物
2026-04-21 优化了GPIO函数，并添加了注释。CMP1输出到PA11，并暂时修改了过流保护值到10A
2026-04-22 修改过流保护
2026-04-22 注释掉没用的外部控制输入函数
2026-04-23 修改了brk中断初始化使能；优化了cmp1初始化的注释
2026-04-23 仿真时重点看这几个状态：
    初始化时 CMP1 没触发：BRKEN=1，BRKIE=1
    初始化时 CMP1 已触发：BRKEN 不打开，BRKIE=0，error_code 置 MC_OVER_CURRENT_ERROR
    运行中触发 CMP1：进一次 TMR1_BRK_TMR9_IRQHandler，然后 BRKIE 被关掉，避免中断风暴
    [mc_hwio.c, mc_isr.c]
2026-04-23 现在逻辑是：tmr_pwm_init() 里不再开机立刻读取 CMP1 并误置 MC_OVER_CURRENT_ERROR，而是先保持 BRK 和 BRK 中断关闭。等 I_offset_init() 完成、第二次 tmr_pwm_init() 后，再调用 ocp_brake_enable_after_startup()，要求 CMP1 连续 5 ms 为 inactive 才真正打开硬件 BR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
2026-04-24 完美的蜂鸣器并唱出天空之城
2026-04-24 删掉没必要的函数
2026-04-24 添加音乐
2026-04-27 解决开环启动根据不同电压的情况下开环参数不固定的情况
2026-05-15 适配a2.0板子
2026-06-03 添加了index
2026-06-03 重新测试action
2026-06-03 继续测试
2026-06-03 测试jekyll
2026-06-03 文档格式
2026-06-03 整理固件源码目录
2026-06-03 添加了intro内容
2026-06-03 更新顶部 GitHub 链接
2026-06-03 移除页面版权页脚
2026-06-03 整理简介文档格式
2026-06-03 更新站点名称为 Tiny_ESC
2026-06-03 将首页合并为简介页
2026-06-03 新增项目文档并修复图片加载
2026-06-03 本地化电机控制图片资源
2026-06-03 添加站内搜索功能
2026-06-03 优化搜索结果标题
2026-06-03 拆分编译和烧录文档
2026-06-03 移动软件环境准备到编译烧录文档
2026-06-03 拆分原理图文档
2026-06-03 合并简介入口
2026-06-03 人工修改下
2026-06-03 调整原理图导航位置
2026-06-04 继续优化文档格式
2026-06-04 继续优化
2026-06-08 修改快速开始
2026-06-08 添加快速开始硬件图片
2026-06-08 写硬件连接
2026-06-08 格式化上位机软件下载链接
2026-06-08 第一次启动电机
2026-06-08 完成快速开始
2026-06-08 完善快速开始
2026-06-08 编译和烧录的软件环境准备
2026-06-08 修复引用图片
2026-06-08 编译和烧录
2026-06-08 在简介添加展示视频
2026-06-08 调整简介视频宽度
2026-06-08 对齐简介视频宽度
2026-06-08 为站点资源添加缓存版本
2026-06-09 变更图片
2026-06-09 为编译烧录图片添加缓存版本
2026-06-09 列出性能调优大纲
2026-06-09 修改参数
2026-06-09 添加测试步骤
2026-06-09 添加电阻阻值修改调试文档
2026-06-09 完善调试文档.
2026-06-10 完善初始化调用
2026-06-10 删掉多余txt
2026-06-10 前置性能调优检查清单
2026-06-10 移除电机控制导航
2026-06-10 删除电机控制文档
2026-06-10 优化代码规范
2026-06-11 更新6S硬件修改电阻参数
2026-06-11 添加硬件修改分压图片
2026-06-11 统一表格字体加粗样式
2026-06-11 替换性能调优增益配置图片
2026-06-11 添加图片点击放大功能
2026-06-11 支持图片预览滚轮缩放
2026-06-11 支持图片预览拖动平移
2026-06-11 保持图片预览关闭按钮置顶
2026-06-11 添加切换控制协议说明
2026-06-11 添加切换协议
2026-06-11 切换控制协议
2026-06-12 添加开源协议
2026-06-12 恢复电机控制文档
2026-06-12 删除多余文件
2026-06-12 添加项目README
2026-08-03 修正了文档分压电阻的的错误
2026-08-04 能够18000rpm
2026-08-04 修改配置文档
2026-08-04 修改配置文档，现在电机能够到达30000rpm
